mattsohnreywilson/5V_Audio_Amp/PCB Prototype BOM.xlsx

Index | Level | Category | Ref Des | P/N | Description | Mfr | Supplier | Supplier Link | Quantity | Cost | Extended Cost
1 | 1 | All | 5V Audio Amplifier
2 | 2 | Electrical | PCB
3 | 3 | Electrical |  | C1206C680J5GACAUTO | SMD AUTO C0G, CERAMIC, 68 PF, 5% | KEMET | Digi-Key | link (https://www.digikey.com/en/products/detail/kemet/C1206C680J5GACAUTO/10232732) | 4 | $0.38 | $1.52
4 | 3 | Electrical |  | C1206C476M8PAC7800 | CAP CER 47UF 10V X5R 1206 | KEMET | Digi-Key | link (https://www.digikey.com/en/products/detail/kemet/C1206C476M8PAC7800/1950668) | 2 | $0.84 | $1.68
5 | 3 | Electrical |  | C1206C105K4PAC7800 | CAP CER 1UF 16V X5R 1206 | KEMET | Digi-Key | link (https://www.digikey.com/en/products/detail/kemet/C1206C105K4PAC7800/7382189) | 4 | $0.48 | $1.92
6 | 3 | Electrical |  | C1206C474K3RAC7800 | CAP CER 0.47UF 25V X7R 1206 | KEMET | Digi-Key | link (https://www.digikey.com/en/products/detail/kemet/C1206C474K3RAC7800/1933629) | 2 | $0.24 | $0.48
7 | 3 | Electrical |  | UCQ1A101MCL1GS | CAP ALUM 100UF 20% 10V SMD | Nichicon | Digi-Key | link (https://www.digikey.com/en/products/detail/nichicon/UCQ1A101MCL1GS/9452730) | 2 | $0.86 | $1.72
8 | 3 | Electrical |  | UUD1A102MNL1GS | CAP ALUM 1000UF 20% 10V SMD | Nichicon | Digi-Key | link (https://www.digikey.com/en/products/detail/nichicon/UUD1A102MNL1GS/589995) | 7 | $0.94 | $6.58
9 | 3 | Electrical |  | CR1206-FX-1002ELF | RES SMD 10K OHM 1% 1/4W 1206 | Bourns | Digi-Key | link (https://www.digikey.com/en/products/detail/bourns-inc/CR1206-FX-1002ELF/2562678) | 8 | $0.10 | $0.80
10 | 3 | Electrical |  | CR1206-FX-2202ELF | RES SMD 22K OHM 1% 1/4W 1206 | Bourns | Digi-Key | link (https://www.digikey.com/en/products/detail/bourns-inc/CR1206-FX-2202ELF/2562866) | 2 | $0.10 | $0.20
11 | 3 | Electrical |  | CR1206-FX-1003ELF | RES SMD 100K OHM 1% 1/4W 1206 | Bourns | Digi-Key | link (https://www.digikey.com/en/products/detail/bourns-inc/CR1206-FX-1003ELF/2562679) | 4 | $0.10 | $0.40
12 | 3 | Electrical |  | CR2512-FX-1001ELF | RES SMD 1K OHM 1% 1W 2512 | Bourns | Digi-Key | link (https://www.digikey.com/en/products/detail/bourns-inc/CR2512-FX-1001ELF/4698114) | 2 | $0.46 | $0.92
13 | 3 | Electrical |  | CRM2512-FX-22R0ELF | RES 22 OHM 1% 2W 2512 | Bourns | Digi-Key | link (https://www.digikey.com/en/products/detail/bourns-inc/CRM2512-FX-22R0ELF/7314831) | 4 | $0.67 | $2.68
14 | 3 | Electrical |  | RMCF1206FT1K40 | RES 1.4K OHM 1% 1/4W 1206 | Stackpole Electronics | Digi-Key | link (https://www.digikey.com/en/products/detail/stackpole-electronics-inc/RMCF1206FT1K40/1758865) | 2 | $0.10 | $0.20
15 | 3 | Electrical |  | CR1206-FX-5111ELF | RES SMD 5.11K OHM 1% 1/4W 1206 | Bourns | Digi-Key | link (https://www.digikey.com/en/products/detail/bourns-inc/CR1206-FX-5111ELF/2563096) | 2 | $0.10 | $0.20
16 | 3 | Electrical |  | CR1206-JW-182ELF | RES SMD 1.8K OHM 5% 1/4W 1206 | Bourns | Digi-Key | link (https://www.digikey.com/en/products/detail/bourns-inc/CR1206-JW-182ELF/3785555) | 4 | $0.10 | $0.40
17 | 3 | Electrical |  | MC3403DR2G | IC OPAMP GP 4 CIRCUIT 14SOIC | Onsemi | Digi-Key | link (https://www.digikey.com/en/products/detail/onsemi/MC3403DR2G/1748995) | 1 | $0.68 | $0.68
18 | 3 | Electrical |  | 2N3904TF | TRANS NPN 40V 0.2A TO92-3 | Onsemi | Digi-Key | link (https://www.digikey.com/en/products/detail/onsemi/2N3904TF/975251) | 4 | $0.38 | $1.52
19 | 3 | Electrical |  | 2N3906TF | TRANS PNP 40V 0.2A TO92-3 | Onsemi | Digi-Key | link (https://www.digikey.com/en/products/detail/onsemi/2N3906TF/975257) | 2 | $0.40 | $0.80
20 | 3 | Electrical |  | SJ1-2503A | CONN JACK STEREO 2.5MM R/A | CUI Devices | Digi-Key | link (https://www.digikey.com/en/products/detail/cui-devices/SJ1-2503A/738680) | 2 | $0.74 | $1.48
21 | 3 | Electrical |  | PJ-037BH-SMT-TR | CONN PWR JACK 2.5X5.5MM SOLDER | CUI Devices | Digi-Key | link (https://www.digikey.com/en/products/detail/cui-devices/PJ-037BH-SMT-TR/1530977) | 1 | $1.51 | $1.51
22 | 3 | Electrical |  | 16-00015 | AC/DC WALL MOUNT ADAPTER 5V 5W | Tensility International Corp | Digi-Key | link (https://www.digikey.com/en/products/detail/tensility-international-corp/16-00015/10324406) | 1 | $7.22 | $7.22
23 | 3 | Electrical |  |  |  |  |  |  |  |  | $0.00
24 | 2 | Mechanical | Standoffs
25 | 3 | Mechanical |  | HTSN-M4-20-8-1 | HEX STANDOFF M4 NYLON 20MM | Essentra Components | Digi-Key | link (https://www.digikey.com/en/products/detail/essentra-components/HTSN-M4-20-8-1/3813430) | 4 | $1.12 | $4.48
26 | 3 | Mechanical |  | 1-18023-1 | SCREW,CAP,SOCKET HEAD (M4X10) | TE Application Tooling | Digi-Key | link (https://www.digikey.com/en/products/detail/te-application-tooling/1-18023-1/5345036) | 4 | $1.11 | $4.44
 |  |  |  |  |  |  |  |  | Total Cost: |  | $41.83
