mattsohnreywilson/5V_Audio_Amp/ECE421FinalProjectV2.asc

C1: cap; 100µ
C2: cap; 1000µ
C3: cap; 467n
C4: cap; 47µ
C5: cap; 1µ
C6: cap; 68p
C7: cap; 68p
C8: cap; 1µ
C9: cap; 100µ
C10: cap; 100µ
Q1: pnp; my_2N3906
Q2: npn; my_2N3904
Q5: npn; my_2N3904
R1: res; 22
R2: res; 7.5k
R4: res; 22
R5: res; 1.8k
R6: res; 1.8k
R8: res; 5.12k
R9: res; 1k
R10: res; 32
R11: res; 220k
R12: res; 10k
R13: res; 100k
R14: res; 10k
R15: res; 10k
R16: res; 10k
R17: res; 100k
U1: UniversalOpamp2
U2: UniversalOpamp2
V1: voltage; 5
V2: voltage; SINE(0 2.5 1000)
V3: voltage; ""; AC 1
Named nets: 0, Vcc, Input
.model my_2N3904 NPN(IS=1E-14 VAF=100
+  Bf=50 IKF=0.4 XTB=1.5 BR=4
+  CJC=4E-12  CJE=8E-12 RB=20 RC=0.1 RE=0.1
+  TR=250E-9  TF=350E-12 ITF=1 VTF=2 XTF=3 Vceo=40 Icrating=200m mfg=NXP)
.model my_2N3906 PNP(IS=1E-14 VAF=100
+  BF=50 IKF=0.4 XTB=1.5 BR=4
+  CJC=4.5E-12 CJE=10E-12 RB=20 RC=0.1 RE=0.1
+  TR=250E-9   TF=350E-12 ITF=1 VTF=2 XTF=3 Vceo=40  Icrating=200m mfg=NXP)
.tran 0.01
