mattsohnreywilson/5V_Audio_Amp/(threads)

Thread 15 (2022-09-18):

Test Prototype

mattsohnreywilson, 2022-09-18:
Finally, test this board for any issues.

Thread 3 (2022-09-18):

Make Final Modifications to Breadboard Prototype and Retest the Design

mattsohnreywilson, 2022-09-18:
After finding the quiescent current issue with the output stage transistors, mods were made to the circuit and the breadboard prototype was retested.

Closed 2022-09-18.

Thread 5 (2022-09-18):

Draw Out Circuit and Determine Resistor/Cap Values

mattsohnreywilson, 2022-09-18:
Draw the audio amplifier circuit and determine what resistor and capacitor values I need for my design specs.

Closed 2022-09-18.

Thread 8 (2022-09-18):

Generate Altium Library

mattsohnreywilson, 2022-09-18:
From the BOM of parts selected for the project, develop and design the parts PCB footprints and schematic symbols in Altium Designer.
